koson/Senior-Project/Report Stuff/leds.jpg

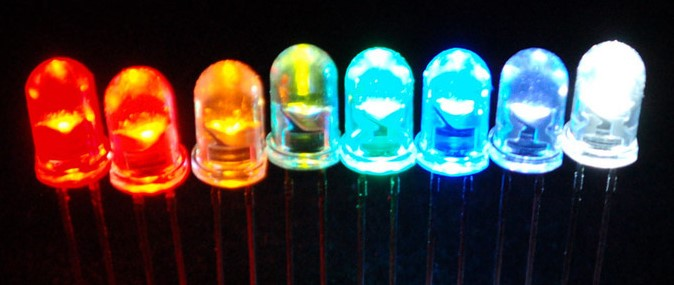
Report Stuff/leds.jpg
