koson/Senior-Project/Report Stuff/keypad.png

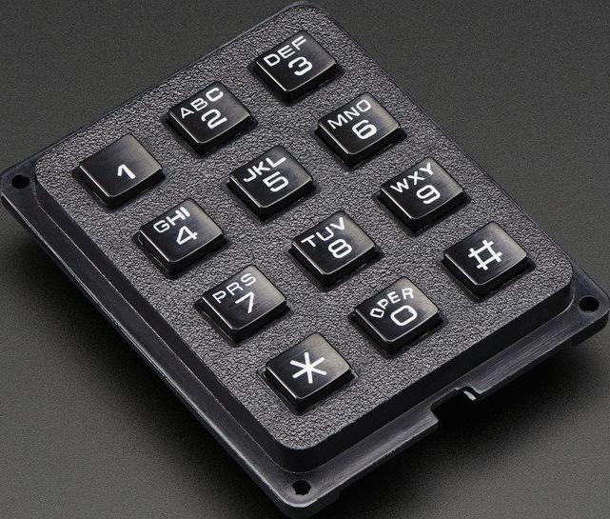
Report Stuff/keypad.png
