koson/Senior-Project/README.txt

This is the repository for the "Granny Safe" senior project
