koson/Senior-Project/Granny Safe Hardware Block Diagram.docx

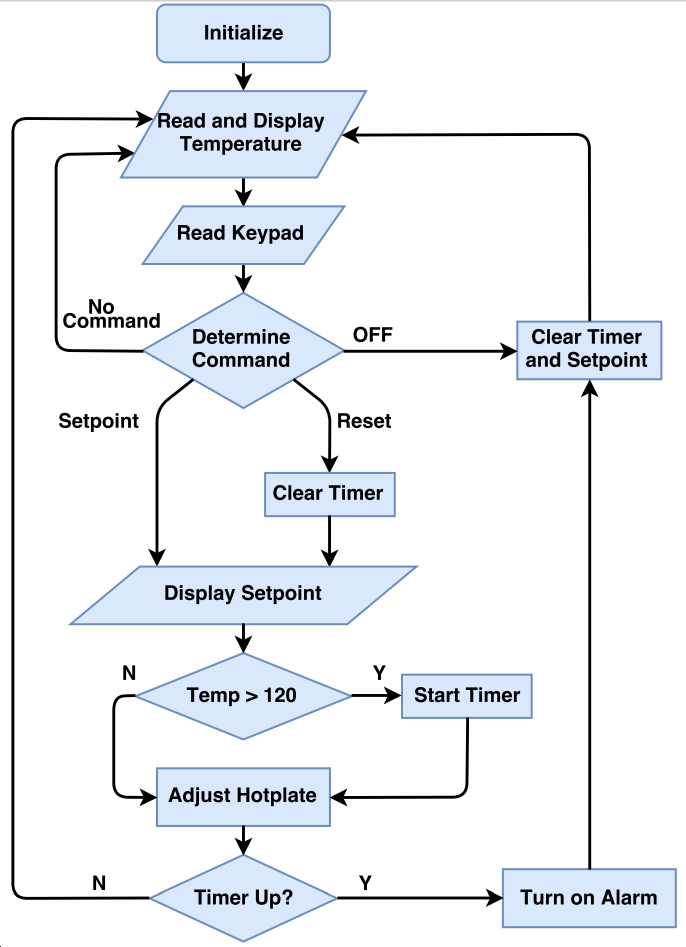
[picture p3: figure]

Granny Safe Software Flow Chart
