koson/Senior-Project/Transmittal Documents/Acknowledgement and Sources.pdf

Acknowledgements:

Nuri, Segee, Sheaf, Payne, Yifeng, Hanselman

Sources:

1. A.S. Sedra, K.C. Smith, “Microelectronic Circuits,” Oxford University Press, New York, New York, pp. 76-80, 2010.
