koson/Senior-Project/402-Design-Review-Rubric.ods

 | Expectations |  | Comments | Weight | Score |  | Expectations |  | Comments | Weight | Score
Docs | Well written and presented progress reports. Schedule, Expense report, and Hardware/software block diagram up is to date and complete. Schematics are to standards, up to date, and complete. Every document has less than two errors. |  |  | 0-10 |  | Hardware Design | Explanation of hardware design is clear, well reasoned, well supported by engineering justifications. Design is clearly communicated during design review. |  |  | 0-40
 |  |  |  |  |  |  | Additionally, the team exhibits the following characteristics to support the design:
Notebooks | Up to date, shows consistent and continuous progress, in ink, signed and dated, and well documented. |  |  | 0-10 |  |  | • | Meets Contract
 | Name : |  |  |  |  |  | • | Scope and depth of project extends well beyond senior level
 | Up to date, shows consistent and continuous progress, in ink, signed and dated, well documented. |  |  | 0-10 |  |  | • | Understanding of design is deep and complete
 | Name: |  |  |  |  |  | • | Circuits used are not copied from course work, app notes, nor data sheets
Test Equip | Test equipment measurement set up correctly and quickly. Oscilloscope usage includes proper horizontal, vertical, differential, and trigger setup. |  |  | 0-10 |  |  | • | Mixed signals and various voltage levels are properly handled correctly
 |  |  |  |  |  |  | • | Modular design is used
Sim & Vrfy | System was thoroughly simulated and/or operation empirically verified. Evidence shown in notebooks. |  |  | 0-10 |  |  | • | Design is thoroughly documented
 |  |  |  |  |  |  | • | Device choices and components are thoroughly researched and considered .
Prototyping | Explanation of prototyping method is clear, well reasoned, well supported by engineering justifications. Design is clearly communicated during design review. |  |  | 0-20 |  | Software Design | Explanation of software design is clear, well reasoned, well supported by engineering justifications. Design is clearly communicated during design review. |  |  | 0
 | Additionally, the team exhibits the following characteristics to support the design: |  |  |  |  |  | Additionally, the team exhibits the following characteristics to support the design:
 | • | PCBs are used and robustly built |  |  |  |  | • | Meets Contract
 | • | Lab power supplies are not used to power the device |  |  |  |  | • | Scope and depth of project extends well beyond senior level
 | • | The device is securely mounted |  |  |  |  | • | Understanding of design is deep and complete
 | • | Proper wire gauges, types, and colors are used |  |  |  |  | • | Array bounds are checked and error appropriately handled
 | • | Power and ground are properly distributed |  |  |  |  | • | Return values are checked and errors appropriately handled
 | • | Power and ground use a connection tree |  |  |  |  | • | Use of global variables is minimal
 | • | Bypass capacitors are properly used |  |  |  |  | • | User input does not make the system fail
 | • | Dangerous voltages cannot contact people |  |  |  |  | • | Structured languages are written to contain functions, modules, and libraries
 | • | Connectors are used and all are labeled |  |  |  |  | • | Coding style and indentation uses accepted practices
 | • | High quality work |  |  |  |  | • | Code is written to be portable
 | • |  |  |  |  |  | • | Algorithms are written to reduce computation
PSF | Scale factor for projects with innovative and in-depth design and meeting dead lines including qualifiers |  |  | % |  |  | • | Interrupts are used appropriately
 |  |  |  |  |  |  | • | Functions have clear and concise interface
 |  |  |  |  |  |  | • | Revision control system used
 |  |  |  |  |  |  | • | Comments clearly describe the algorithmic design
 |  | Name : | Grade |  | 0 |  |  | Name: | Grade |  | 0
