koson/Senior-Project/2624_001.pdf

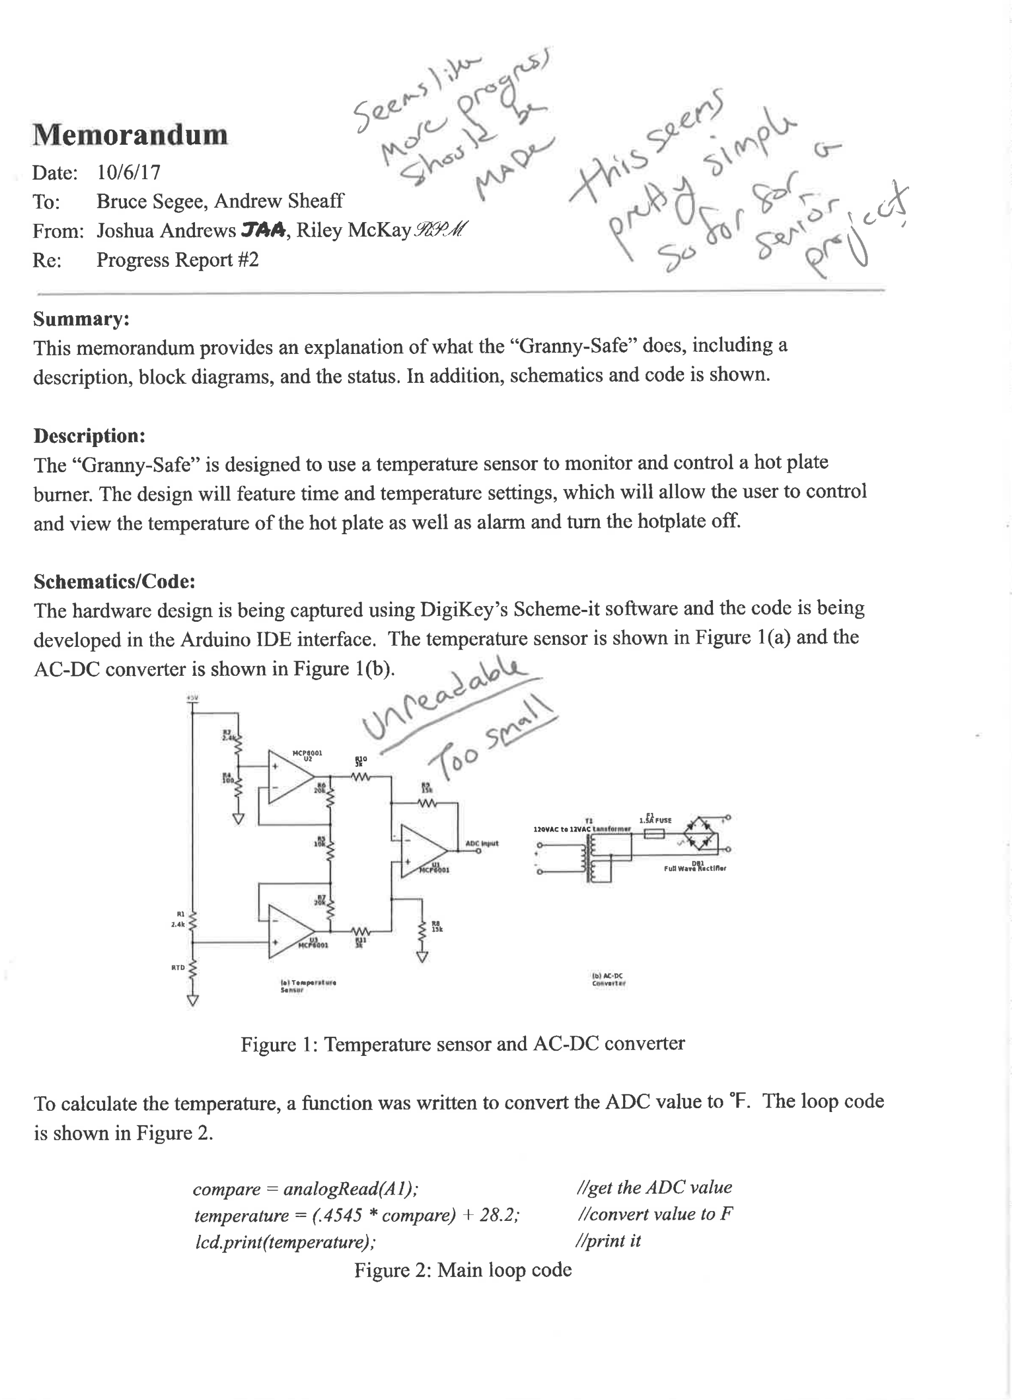
[picture p29: page 1]
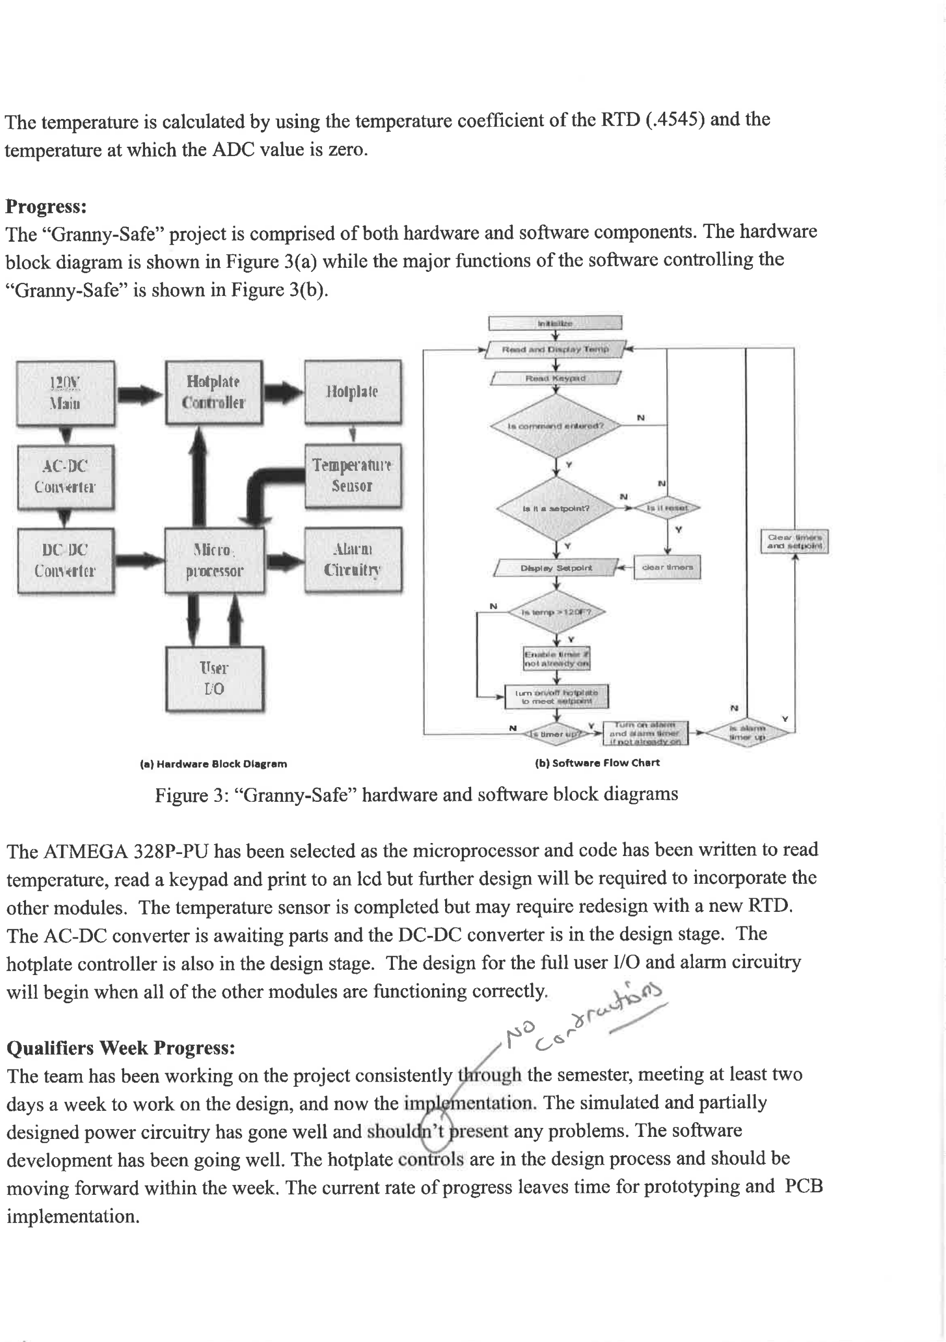
[picture p30: page 2]
