koson/Senior-Project/Transmittal Documents/Memorandum 1 ECP403.pdf

## Memorandum

Date: 1/28/18
To: Elizabeth Payne
From: Joshua Andrews JAA, Riley McKay RPM
Re: Memo assignment: Introduction, block diagram, explanation of signal flow, two outlines, a list of sources and acknowledgments, and a copy of the project contract

Here are the documents you requested on 1/22/18. They consist of the introduction, block diagram and explanation, an outline from each team partner, sources and acknowledgements, and the contract for the project.
