koson/Senior-Project/Report Stuff/CSVs/triac1.xlsx

Time(Second) | X(CH1) (Volt)
-0.029999997 | -12
-0.029899998 | -12
-0.029799998 | -12
-0.029699998 | -10
-0.029599998 | -12
-0.029499998 | -12
-0.029399998 | -12
-0.029299999 | -12
-0.029199999 | -10
-0.029099999 | -12
-0.028999999 | -10
-0.028899999 | -8
-0.0288 | -8
-0.0287 | -10
-0.0286 | -10
-0.0285 | -8
-0.0284 | -8
-0.0283 | -12
-0.028200001 | -10
-0.028100001 | -8
-0.028000001 | -8
-0.027900001 | -6
-0.027800001 | -8
-0.027700001 | -2
-0.027600002 | -6
-0.027500002 | -2
-0.027400002 | -2
-0.027300002 | -2
-0.027200002 | -2
-0.027100002 | -2
-0.027000003 | -2
-0.026900003 | -2
-0.026800003 | -2
-0.026700003 | -2
-0.026600003 | -2
-0.026500003 | 0
-0.026400004 | -2
-0.026300004 | 0
-0.026200004 | 0
-0.026100004 | -2
-0.026000004 | 2
-0.025900004 | 4
-0.025800005 | 4
-0.025700005 | 6
-0.025600005 | 6
-0.025500005 | 6
-0.025400005 | 6
-0.025300005 | 6
-0.025200006 | 6
-0.025100006 | -124
-0.025000006 | -128
-0.024900006 | -118
-0.024800006 | -118
-0.024700006 | -102
-0.024600007 | -104
-0.024500007 | -94
-0.024400007 | -92
-0.024300007 | -82
-0.024200007 | -80
-0.024100007 | -70
-0.024000008 | -66
-0.023900008 | -52
-0.023800008 | -52
-0.023700008 | -42
-0.023600008 | -40
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
