koson/Senior-Project/Report Stuff/CSVs/setacc.xlsx

stdH | stdL | setpoint
98 | 102 | 100
103 | 106.5 | 105
107.5 | 112 | 110
112.5 | 116.5 | 115
117.5 | 122 | 120
123 | 127 | 125
128 | 132.5 | 130
133 | 136.5 | 135
138 | 142 | 140
143.5 | 147 | 145
148 | 152 | 150
153 | 158 | 155
156 | 163 | 160
162.5 | 167.5 | 165
167.5 | 173 | 170
173 | 177 | 175
178 | 182 | 180
183.5 | 187.5 | 185
188 | 192 | 190
193 | 197 | 195
198 | 203 | 200
203 | 207 | 205
208 | 213 | 210
213 | 217 | 215
218 | 221.5 | 220
223 | 227.5 | 225
228 | 232 | 230
233 | 237.5 | 235
237.5 | 242 | 240
242 | 246.5 | 245
249 | 253 | 250
252 | 258.5 | 255
258.5 | 262 | 260
263 | 267 | 265
268 | 273 | 270
272 | 278.5 | 275
277 | 282 | 280
282 | 287 | 285
288 | 292 | 290
293 | 298 | 295
298 | 302 | 300
303 | 307 | 305
308 | 312 | 310
312 | 317.5 | 315
318 | 322 | 320
323 | 327 | 325
328 | 332 | 330
333 | 337 | 335
338 | 342 | 340
340 | 347 | 345
346 | 355 | 350
352 | 358 | 355
358 | 362 | 360
362 | 367 | 365
367 | 374 | 370
373 | 377 | 375
377.5 | 382 | 380
382 | 388 | 385
385 | 393 | 390
392 | 397 | 395
396 | 405 | 400
