koson/Senior-Project/Report Stuff/CSVs/tempaccuracy.xlsx

act | meas | err
100 | 99.3 | 0.7
105 | 104.4 | 0.6
110 | 109.4 | 0.6
115 | 114.5 | 0.5
120 | 119.5 | 0.5
125 | 124.5 | 0.5
130 | 129.6 | 0.4
135 | 134.6 | 0.4
140 | 139.6 | 0.4
145 | 144.6 | 0.4
150 | 149.7 | 0.3
155 | 154.7 | 0.3
160 | 159.7 | 0.3
165 | 164.8 | 0.2
170 | 169.8 | 0.2
175 | 174.8 | 0.2
180 | 179.8 | 0.2
185 | 184.8 | 0.2
190 | 189.8 | 0.2
195 | 194.9 | 0.1
200 | 199.9 | 0.1
205 | 205 | 0
210 | 210 | 0
215 | 215.1 | 0.1
220 | 220.1 | 0.1
225 | 225.1 | 0.1
230 | 230.1 | 0.1
235 | 235.2 | 0.2
240 | 240.2 | 0.2
245 | 245.3 | 0.3
250 | 250.3 | 0.3
255 | 255.3 | 0.3
260 | 260.4 | 0.4
265 | 265.4 | 0.4
270 | 270.5 | 0.5
275 | 275.5 | 0.5
280 | 280.5 | 0.5
285 | 285.6 | 0.6
290 | 290.6 | 0.6
295 | 295.6 | 0.6
300 | 300.7 | 0.7
305 | 305.7 | 0.7
310 | 310.6 | 0.6
315 | 315.7 | 0.7
320 | 320.7 | 0.7
325 | 325.8 | 0.8
330 | 330.8 | 0.8
335 | 335.8 | 0.8
340 | 340.8 | 0.8
345 | 345.8 | 0.8
350 | 350.9 | 0.9
355 | 355.9 | 0.9
360 | 360.9 | 0.9
365 | 365.9 | 0.9
370 | 371 | 1
375 | 376 | 1
380 | 381 | 1
385 | 386 | 1
390 | 391.1 | 1.1
395 | 396.1 | 1.1
400 | 401.2 | 1.2
