koson/Senior-Project/Atmega/Atmega328 pinout.png

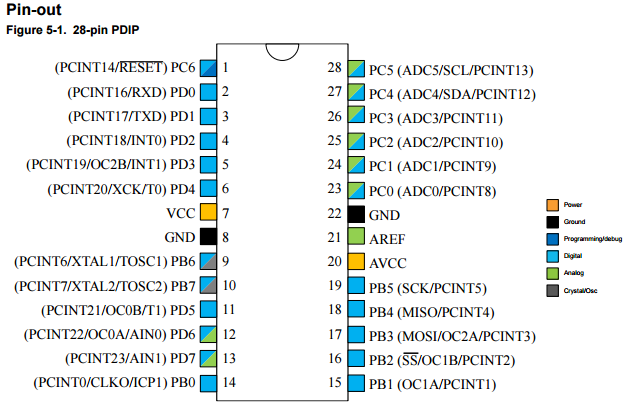
Atmega/Atmega328 pinout.png
