koson/Senior-Project/Gifs-Presentation/grandmother.png

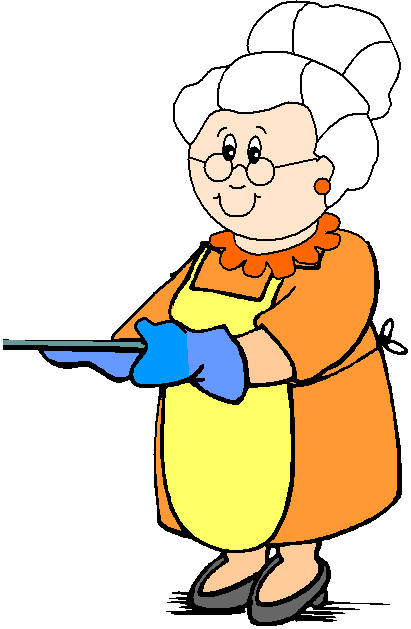
Gifs-Presentation/grandmother.png
