koson/Senior-Project/Gifs-Presentation/tenor (1).gif

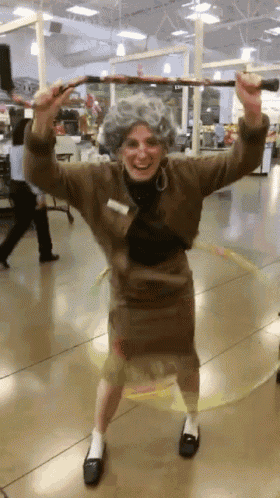
Gifs-Presentation/tenor (1).gif
