koson/Senior-Project/Gifs-Presentation/tenor (2).gif

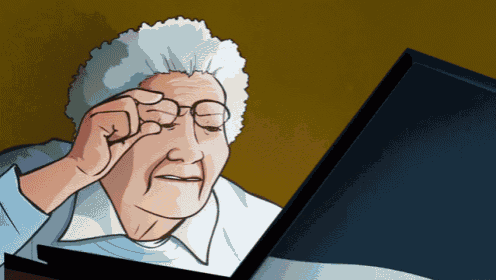
Gifs-Presentation/tenor (2).gif
