koson/Senior-Project/Gifs-Presentation/tenor (3).gif

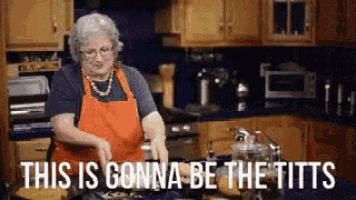
Gifs-Presentation/tenor (3).gif
