koson/Senior-Project/Gifs-Presentation/tenor (4).gif

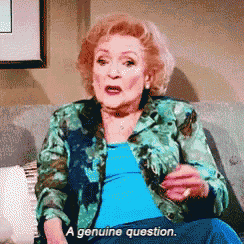
Gifs-Presentation/tenor (4).gif
