koson/Senior-Project/Gifs-Presentation/tenor (5).gif

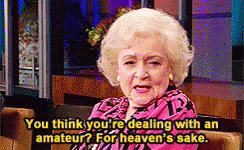
Gifs-Presentation/tenor (5).gif
