koson/Senior-Project/Gifs-Presentation/tenor.gif

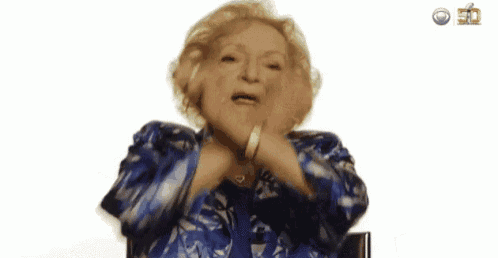
Gifs-Presentation/tenor.gif
