koson/Senior-Project/Pictures/20170405_121246.jpg

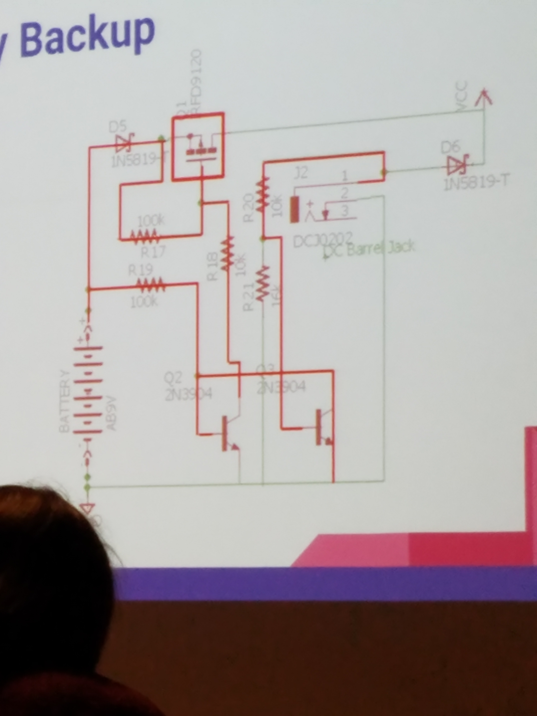
Pictures/20170405_121246.jpg
