koson/Senior-Project/Pictures/20170405_121846.jpg

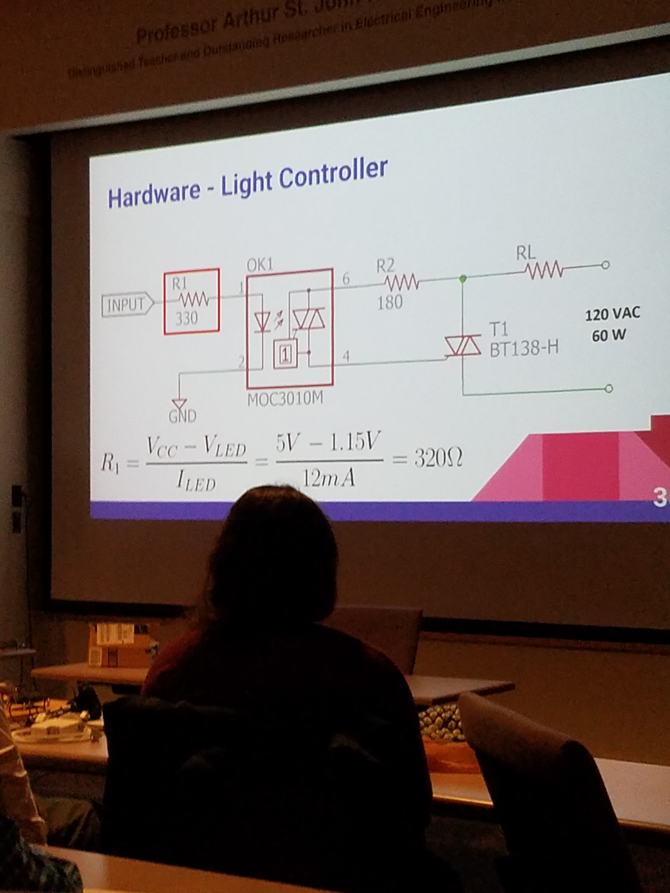
Pictures/20170405_121846.jpg
