koson/Senior-Project/Pictures/20170405_121858.jpg

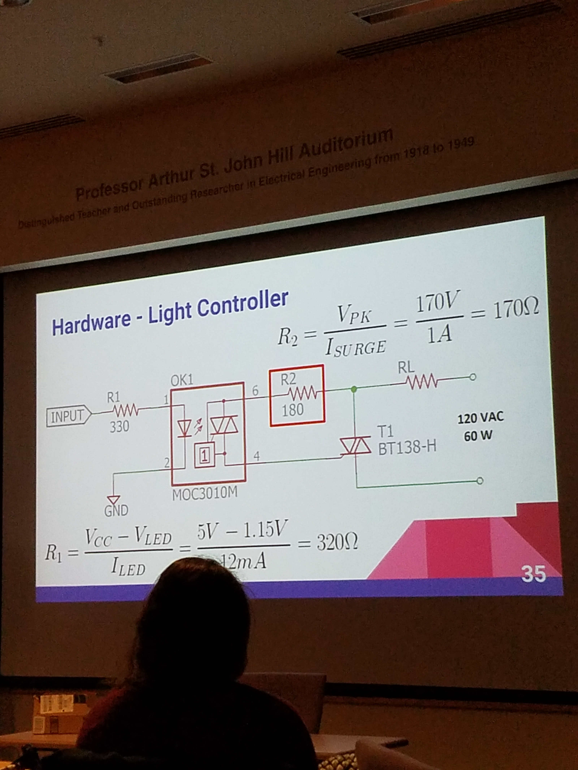
Pictures/20170405_121858.jpg
