koson/Senior-Project/Pictures/IOpin.png

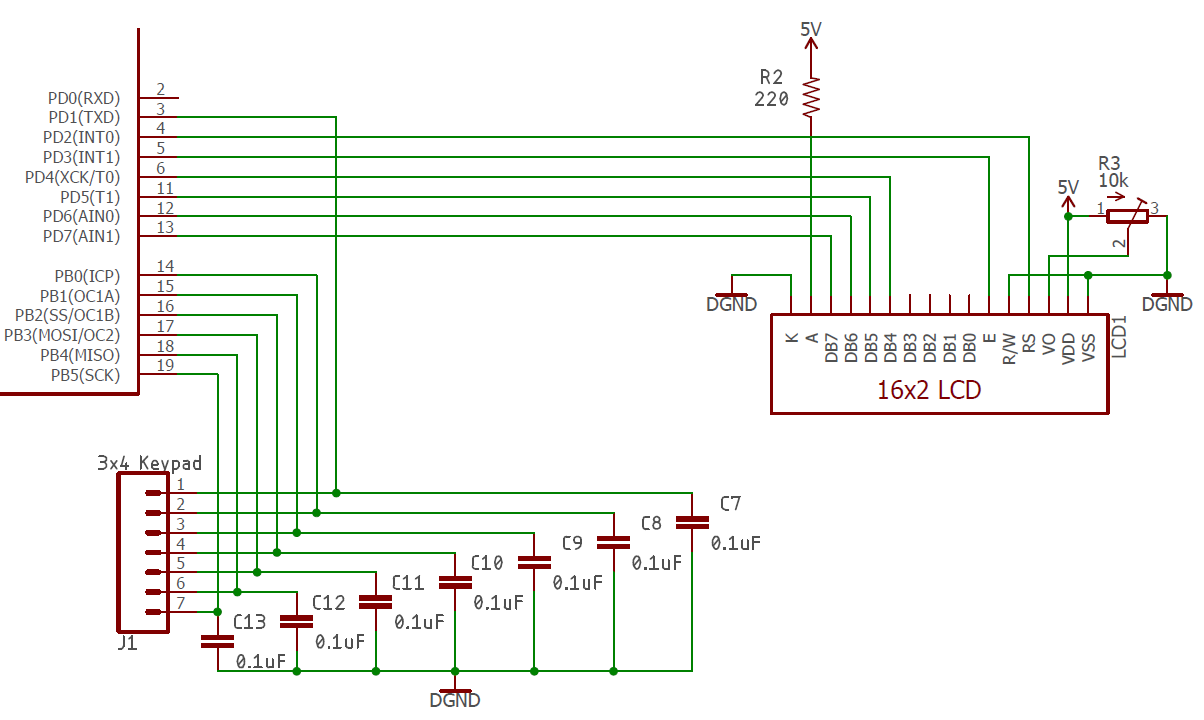
Pictures/IOpin.png
