koson/Senior-Project/Pictures/Microprocessor Circuitry.png

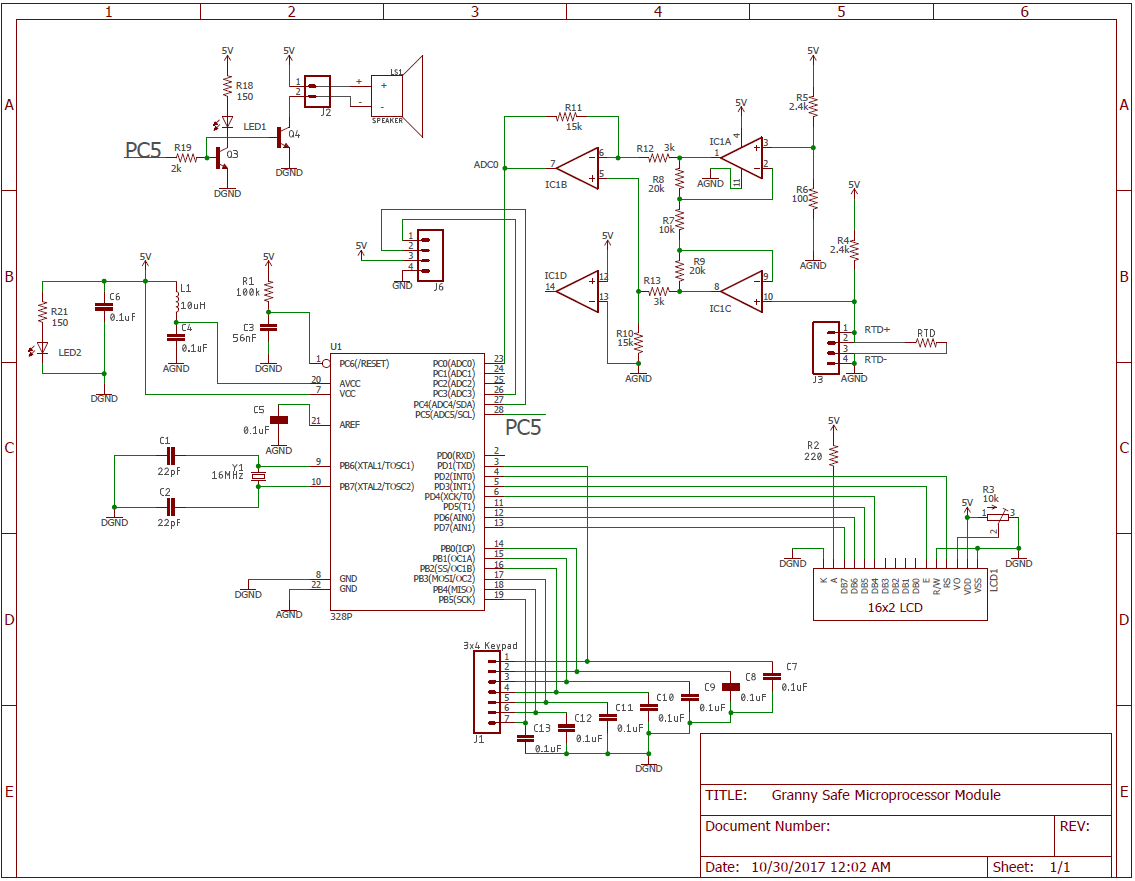
Pictures/Microprocessor Circuitry.png
