koson/Senior-Project/Pictures/Power Supply.png

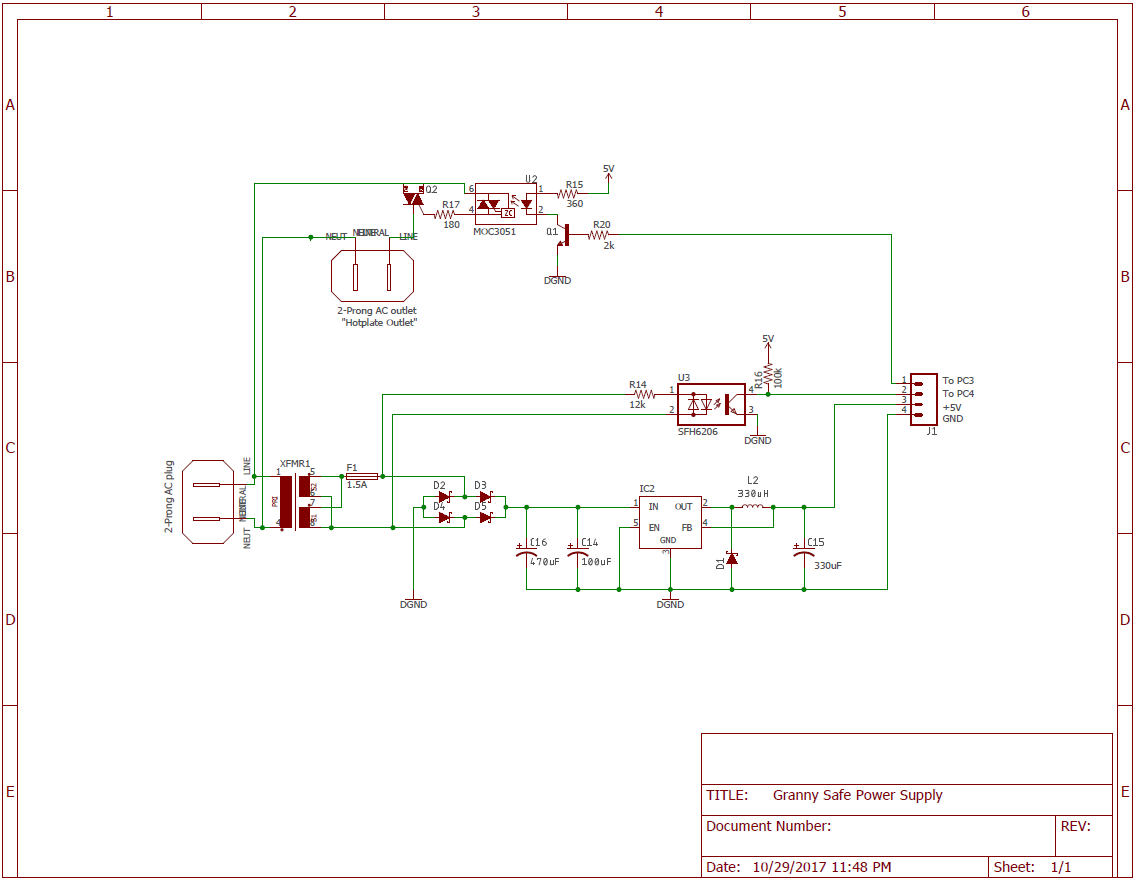
Pictures/Power Supply.png
