koson/Senior-Project/Pictures/Tempsens.png

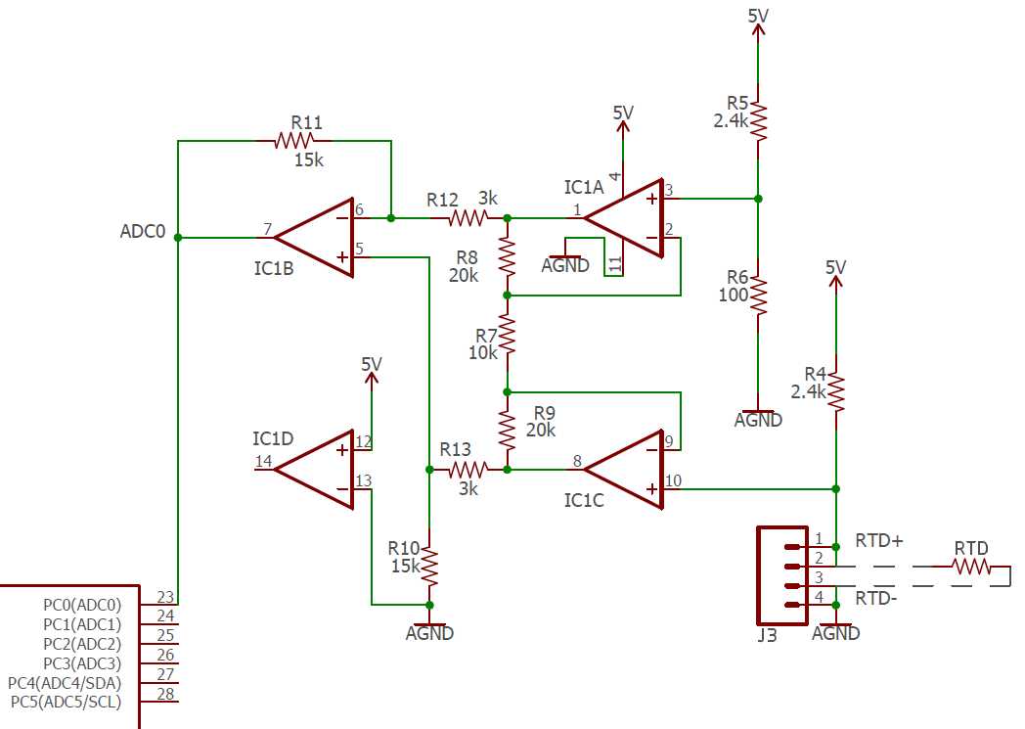
Pictures/Tempsens.png
