koson/Senior-Project/Pictures/Triac.png

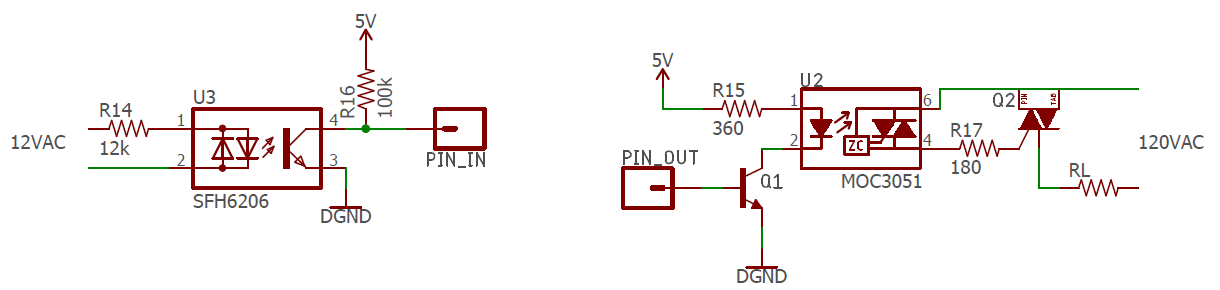
Pictures/Triac.png
