koson/Senior-Project/Report Stuff/alarmled (adafruit).png

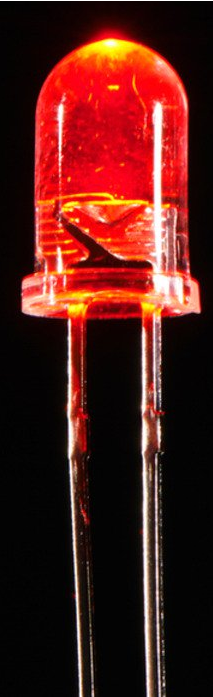
Report Stuff/alarmled (adafruit).png
