koson/Senior-Project/Report Stuff/alarmsch.png

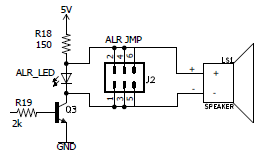
Report Stuff/alarmsch.png
