koson/Senior-Project/Report Stuff/anova.jpg

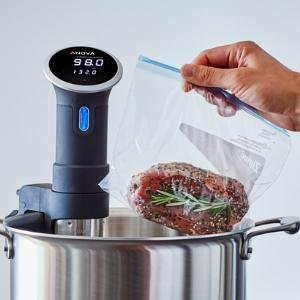
Report Stuff/anova.jpg
