koson/Senior-Project/Report Stuff/arduino uno.png

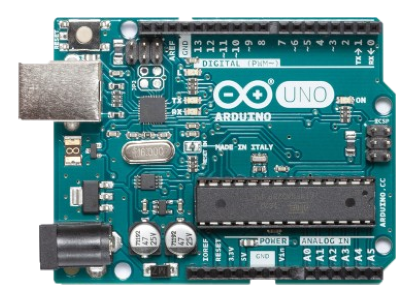
Report Stuff/arduino uno.png
