koson/Senior-Project/Report Stuff/Atmega chip.jpg

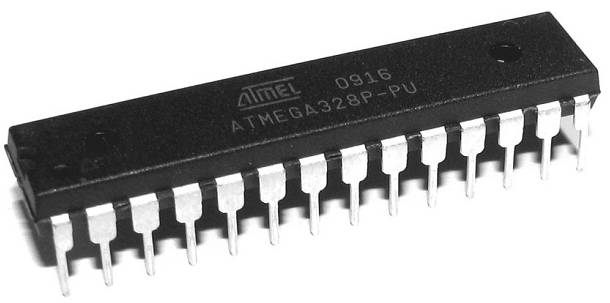
Report Stuff/Atmega chip.jpg
