koson/Senior-Project/Report Stuff/Block Diagram 3.0 (1).png

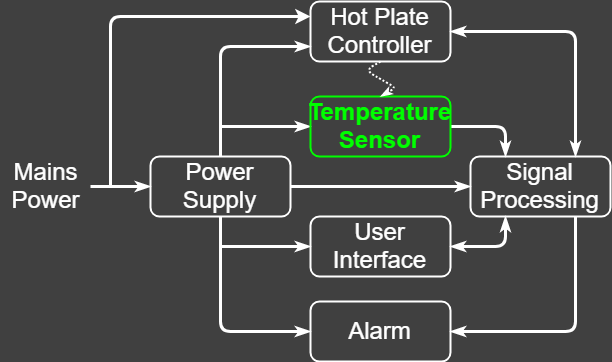
Report Stuff/Block Diagram 3.0 (1).png
