koson/Senior-Project/Report Stuff/Buck-Converter.png

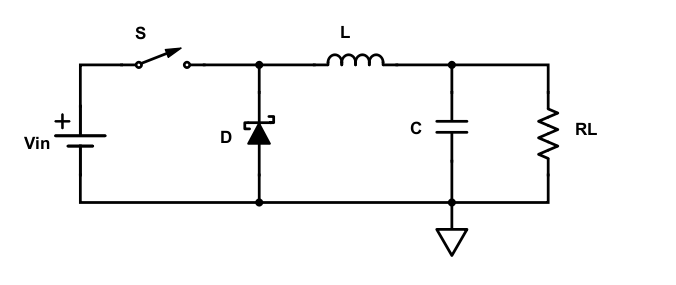
Report Stuff/Buck-Converter.png
