koson/Senior-Project/Report Stuff/currentspec.jpg

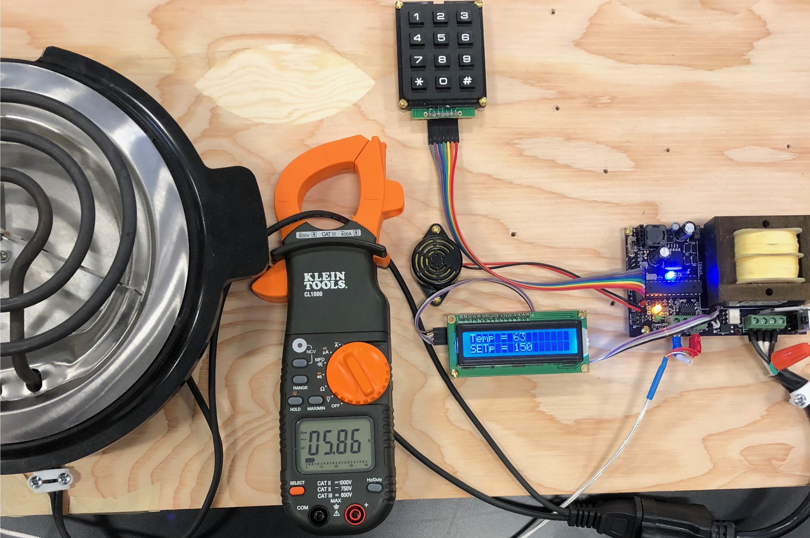
Report Stuff/currentspec.jpg
