koson/Senior-Project/Report Stuff/equiv triac.png

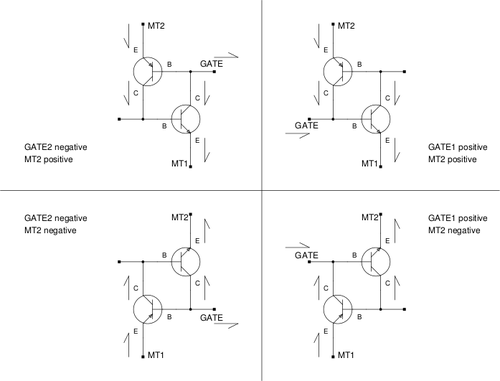
Report Stuff/equiv triac.png
