koson/Senior-Project/Report Stuff/fire advert.png

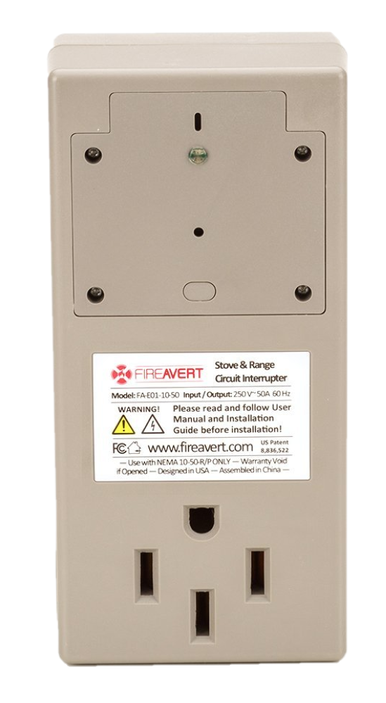
Report Stuff/fire advert.png
