koson/Senior-Project/Report Stuff/iguard.png

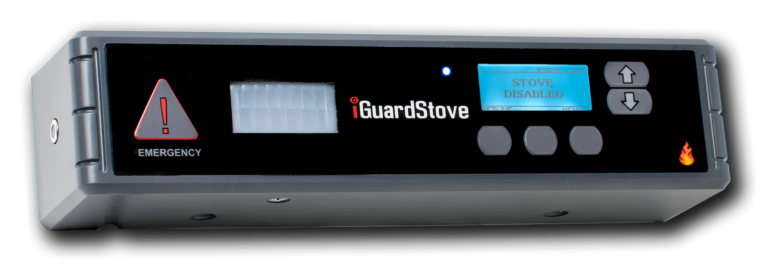
Report Stuff/iguard.png
