koson/Senior-Project/Report Stuff/IMG-0240.JPG

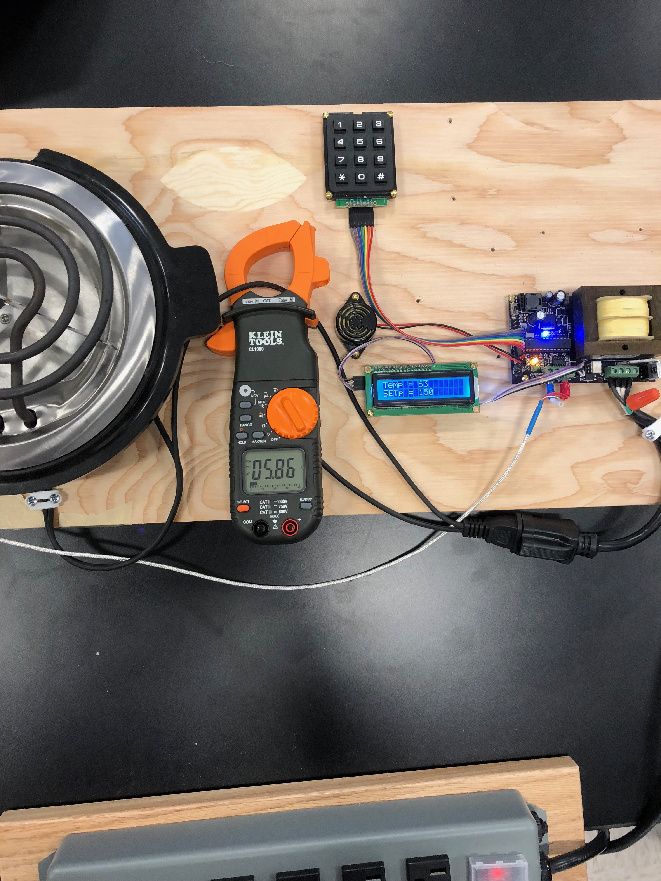
Report Stuff/IMG-0240.JPG
