koson/Senior-Project/Report Stuff/kitchenfire.jpg

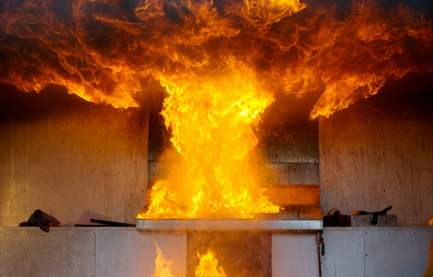
Report Stuff/kitchenfire.jpg
