koson/Senior-Project/Report Stuff/lcd.jpg

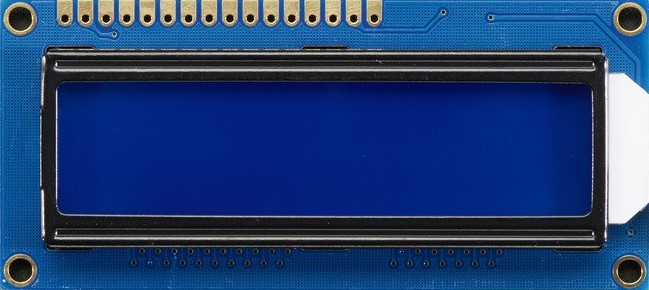
Report Stuff/lcd.jpg
