koson/Senior-Project/Report Stuff/piezo.jpg

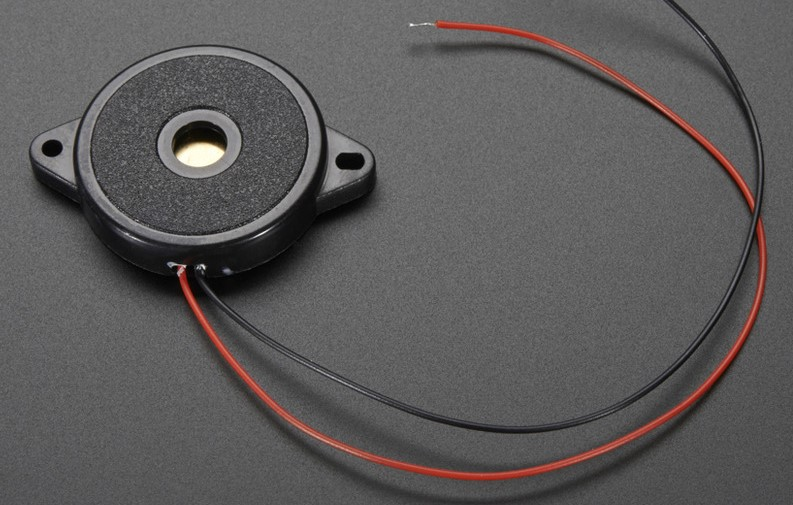
Report Stuff/piezo.jpg
