koson/Senior-Project/Report Stuff/pwrsup_sch.png

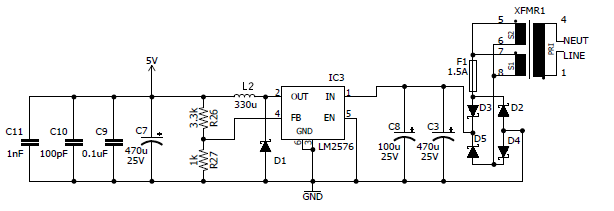
Report Stuff/pwrsup_sch.png
