koson/Senior-Project/Report Stuff/rectifier.png

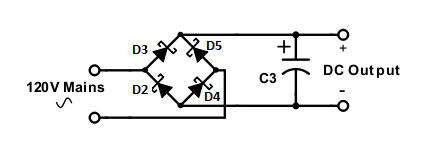
Report Stuff/rectifier.png
