koson/Senior-Project/Report Stuff/rtd.jpg

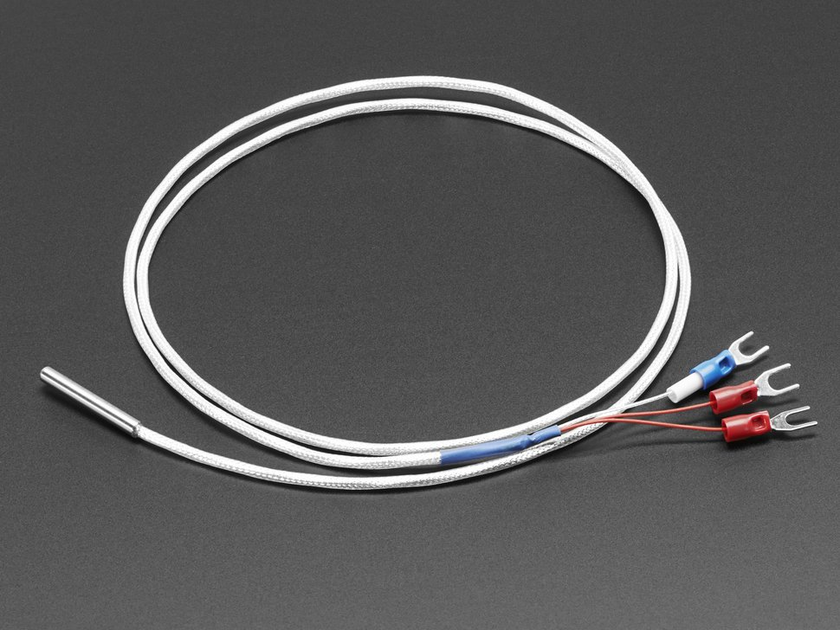
Report Stuff/rtd.jpg
