koson/Senior-Project/Report Stuff/safety.png

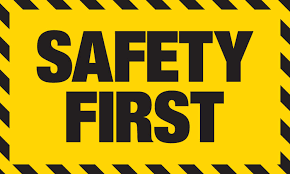
Report Stuff/safety.png
