koson/Senior-Project/Report Stuff/schematic for presentation.png

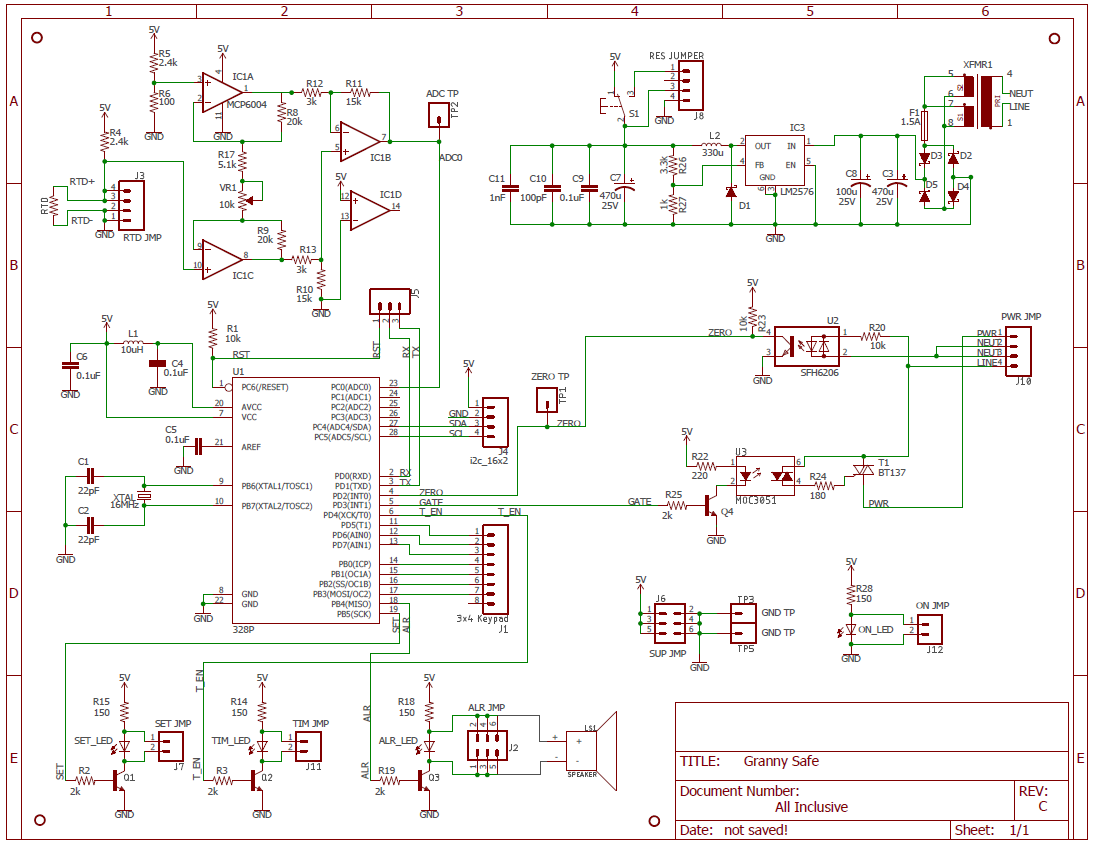
Report Stuff/schematic for presentation.png
