koson/Senior-Project/Report Stuff/Tempsensor.png

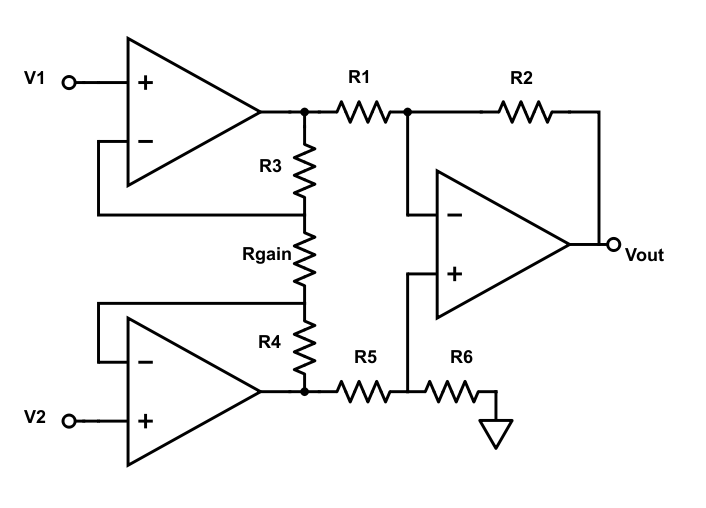
Report Stuff/Tempsensor.png
