koson/Senior-Project/Report Stuff/timing_as.gif

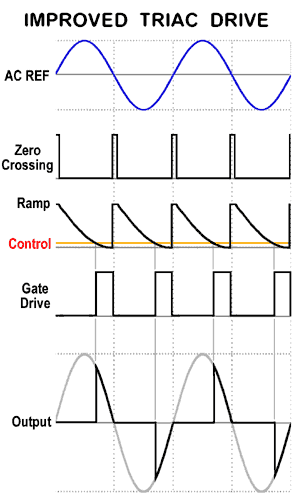
Report Stuff/timing_as.gif
