koson/Senior-Project/Report Stuff/triac ac wave.jpg

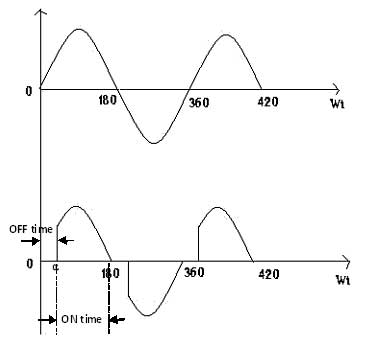
Report Stuff/triac ac wave.jpg
