koson/Senior-Project/Report Stuff/triac contruction.gif

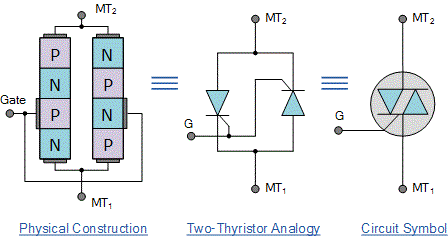
Report Stuff/triac contruction.gif
