koson/Senior-Project/Report Stuff/triac_control_sch.png

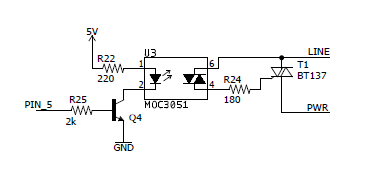
Report Stuff/triac_control_sch.png
