koson/Senior-Project/Report Stuff/Zero+triac.png

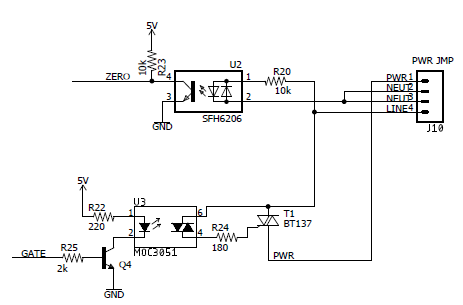
Report Stuff/Zero+triac.png
