koson/Senior-Project/Report Stuff/zsense_sch.png

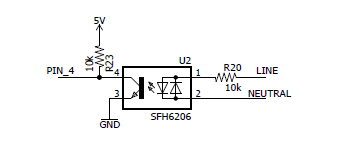
Report Stuff/zsense_sch.png
