koson/Senior-Project/Pictures/328setup.png

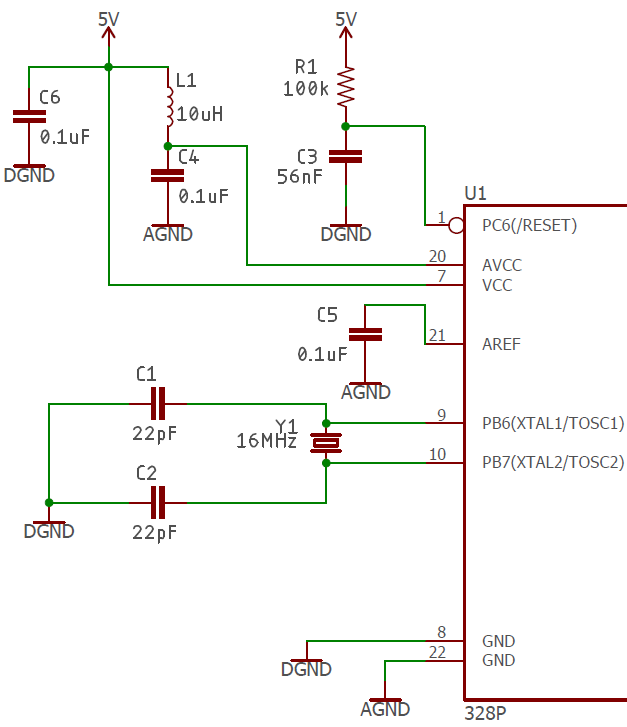
Pictures/328setup.png
