koson/Senior-Project/Black Schematic.pdf

# 6 R²⁶ R²⁷

A

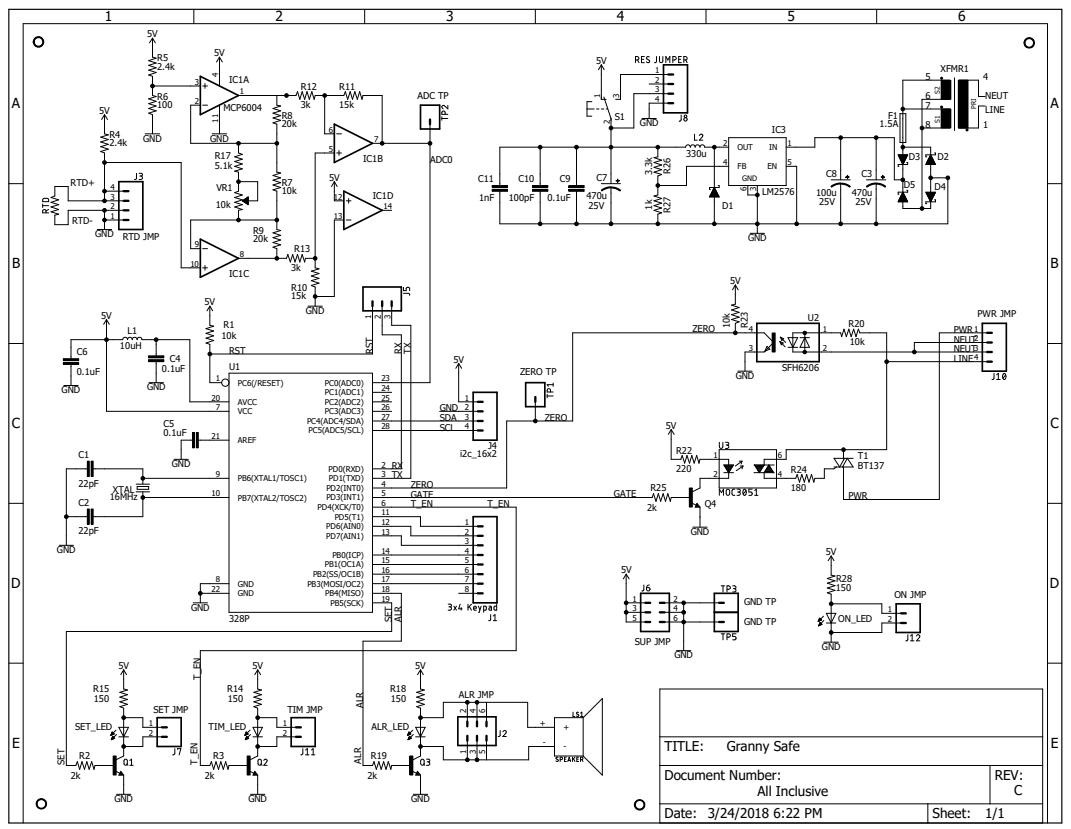
[picture p79: page 1]

Document Number: All Inclusive | REV: C

Date: 3/24/2018 6:22 PM | Sheet: 1/1
