koson/Senior-Project/Cut up schematic for report.pdf

# 6 R²⁶ R²⁷

# ADC0 T_EN

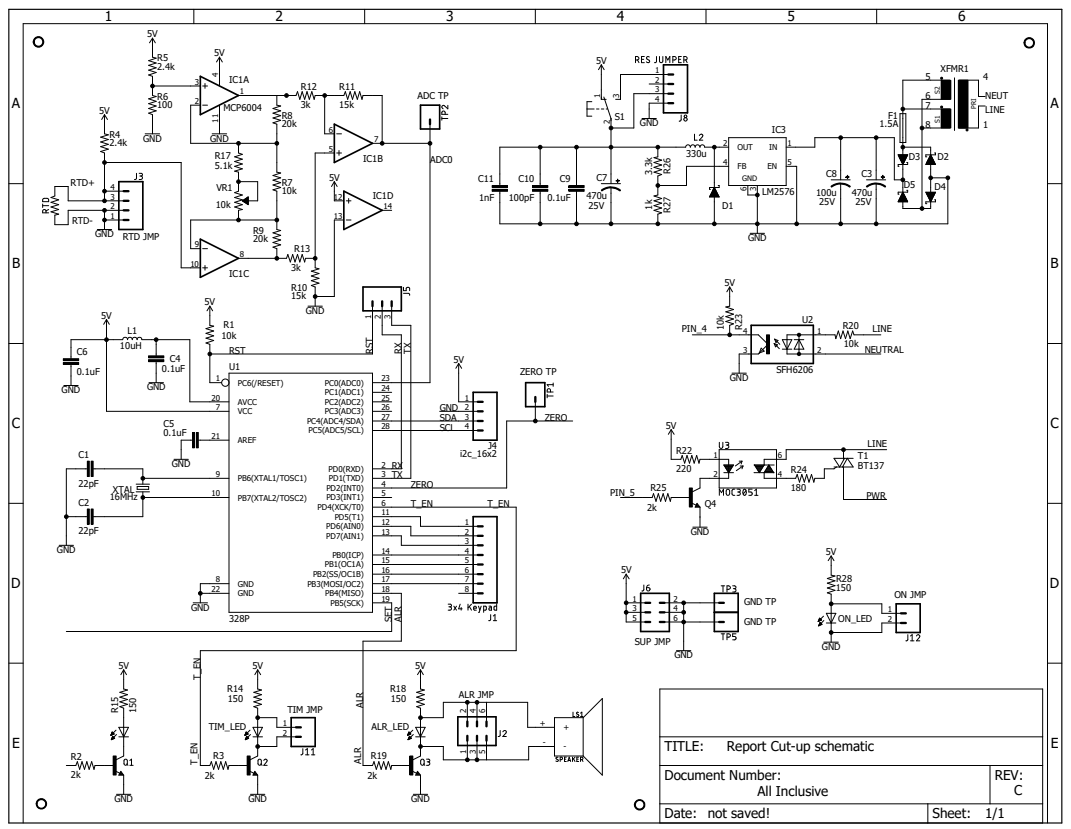
[picture p80: page 1]

Document Number: All Inclusive | REV: C

Date: not saved! | Sheet: 1/1
