koson/Senior-Project/Granny Safe Schematic 12-13-17.pdf

# 6 R²⁶ R²⁷

A

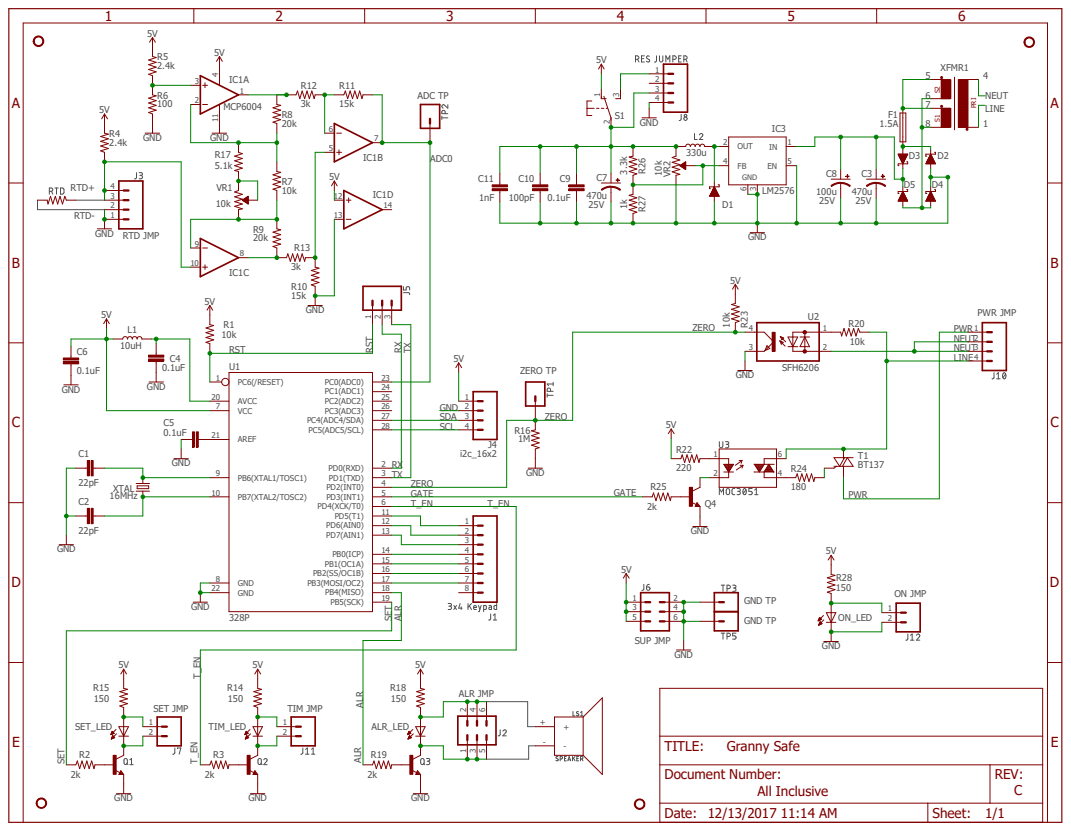
[picture p81: page 1]

Document Number: All Inclusive | REV: C

Date: 12/13/2017 11:14 AM | Sheet: 1/1
