koson/Senior-Project/Report Stuff/Granny Safe Schematic 3-24-17.pdf

# 6 R²⁶ R²⁷

A

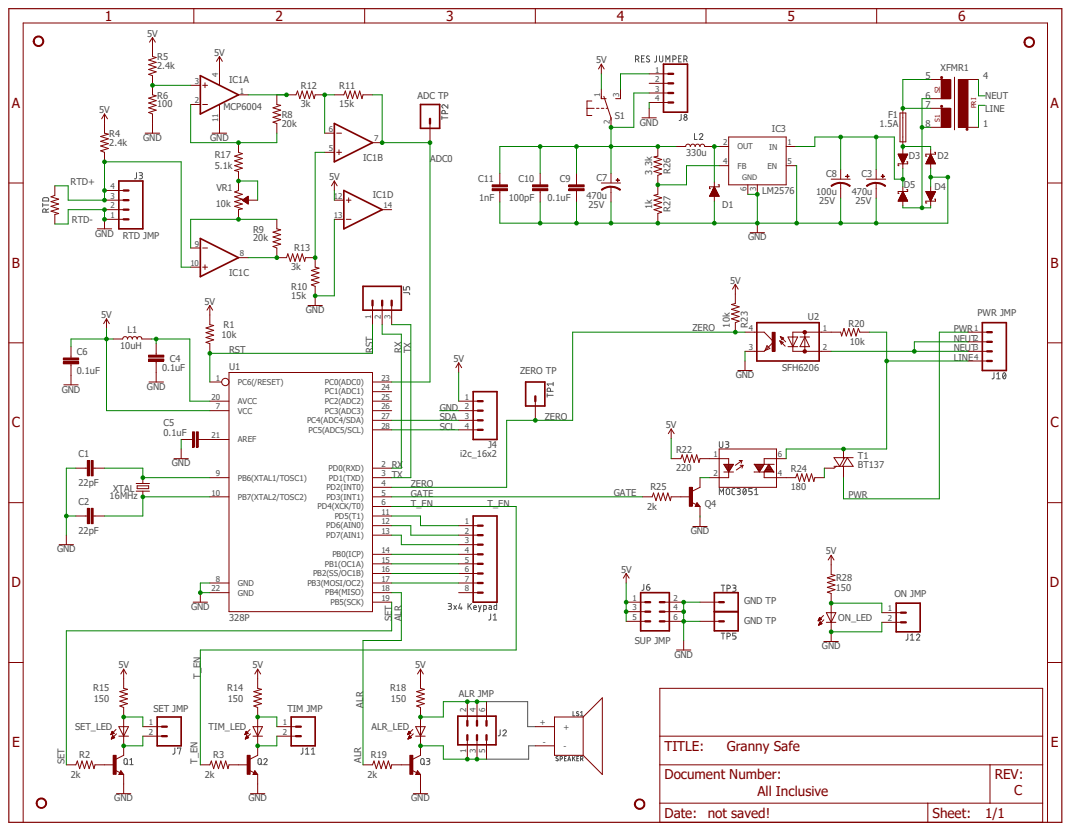
[picture p82: page 1]

Document Number: All Inclusive | REV: C

Date: not saved! | Sheet: 1/1
