koson/Senior-Project/Granny-Safe all in one.pdf

A

A

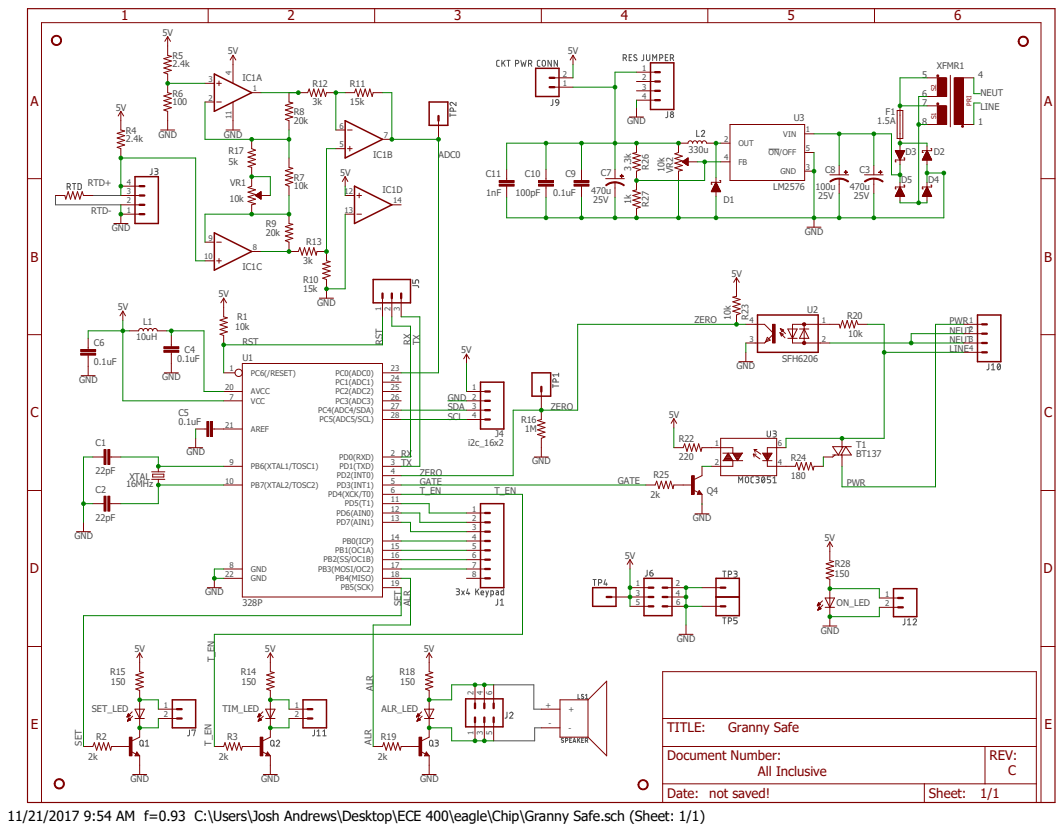
[picture p83: page 1]

Document Number: All Inclusive | REV: C

Date: not saved! | Sheet: 1/1

11/21/2017 9:54 AM f=0.93 C:\Users\Josh Andrews\Desktop\ECE 400\eagle\Chip\Granny Safe.sch (Sheet: 1/1)
