koson/Senior-Project/eagle/Temp Sensor/Temp Sensor.brd

## EAGLE design eagle/Temp Sensor/Temp Sensor.brd (2018-05-23)

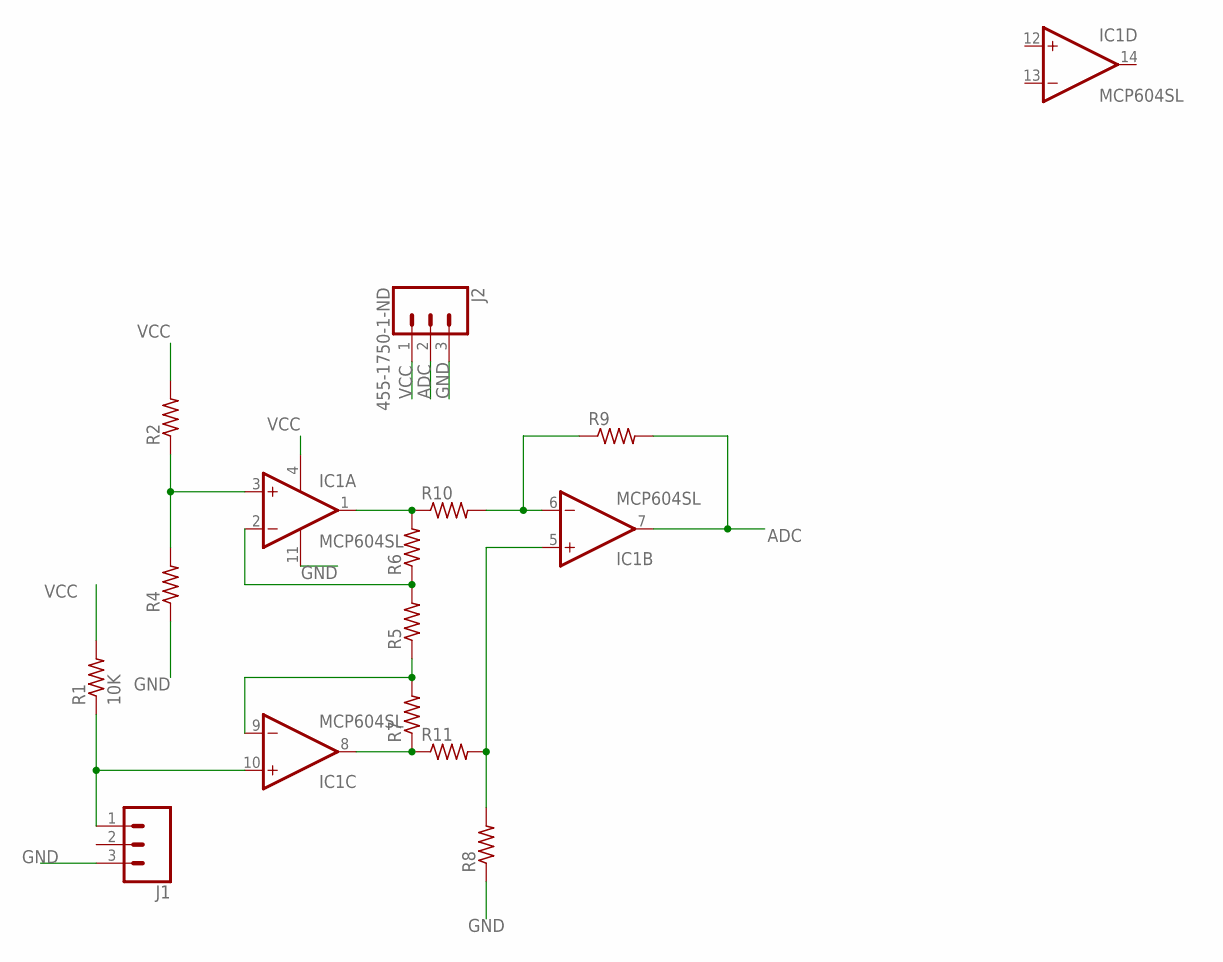
[picture p85: schematic Temp Sensor.sch]

Parts:
IC1: MCP604SL; SO14
J1: CONN_03SCREW_LOCK; SCREWTERMINAL-3.5MM-3_LOCK.007S
J2: 455-1750-1-ND; 1X03
R1: 10K; R0603
R2, R4, R5, R6, R7, R8, R9, R10, R11: R-US_R0603; R0603

Connections:
ADC: IC1.7 (OUT), J2.2, R9.2
GND: IC1.11 (V-), J1.3, J2.3, R4.1, R8.1
unnamed: IC1.10 (+IN), J1.1, R1.1
unnamed: IC1.3 (+IN), R2.1, R4.2
unnamed: IC1.8 (OUT), R7.1, R11.1
unnamed: IC1.1 (OUT), R6.2, R10.1
unnamed: IC1.2 (-IN), R5.2, R6.1
unnamed: IC1.9 (-IN), R5.1, R7.2
unnamed: IC1.5 (+IN), R8.2, R11.2
unnamed: IC1.6 (-IN), R9.1, R10.2
VCC: IC1.4 (V+), J2.1, R1.2, R2.2

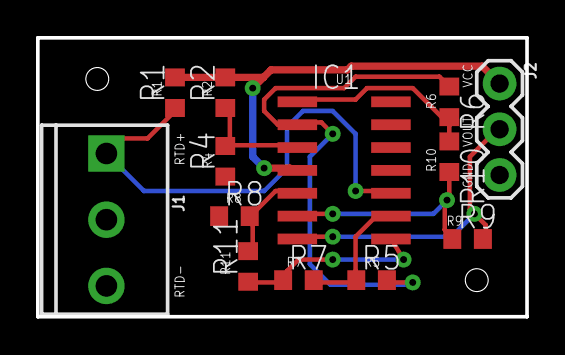
[picture p86: board Temp Sensor.brd from above]

Board: 2 copper layers, 27.2 x 15.5 mm, 13 parts (0 on the bottom side), 11 nets.
