koson/Senior-Project/eagle/Triac/Triac.brd

## EAGLE design eagle/Triac/Triac.brd (2018-05-23)

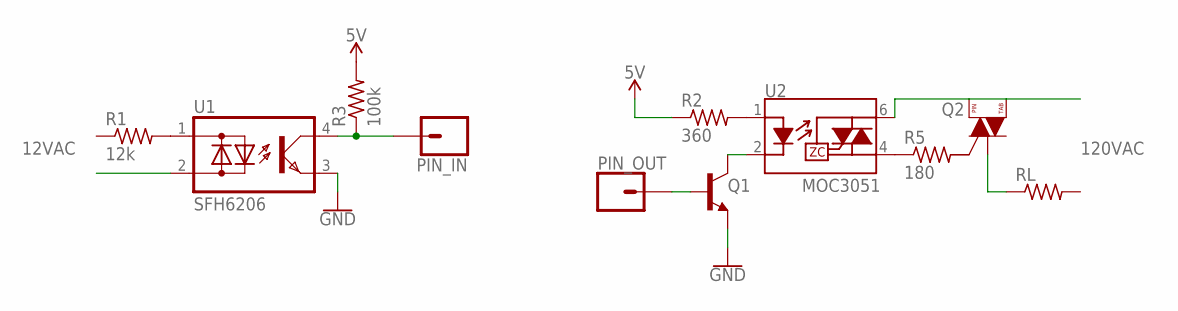
[picture p87: schematic Triac.sch]

Parts:
PIN_IN: CONN_01; 1X01
PIN_OUT: CONN_01; 1X01
Q1: TRANS_NPN-MMBTA42; SOT23-3
Q2: BT137-600E; SOT223
R1: 12k; R0603
R2: 360; R0603
R3: 100k; R0603
R5: 180; R0603
RL: R-US_R0603; R0603
U1: SFH6206; DIL4-SMD
U2: TRIAC_OPTOCOUPLER-MOC3063SM; DIP8SMD

Connections:
5V: R2.1, R3.2
GND: Q1.2 (E), U1.3 (E)
unnamed: R1.2, U1.1 (AC1)
unnamed: PIN_IN.1, R3.1, U1.4 (C)
unnamed: R2.2, U2.1 (A)
unnamed: R5.1, U2.4 (T2)
unnamed: Q2.2 (T2), Q2.4 (T2), U2.6 (T1)
unnamed: Q1.3 (C), U2.2 (K)
unnamed: PIN_OUT.1, Q1.1 (B)
unnamed: Q2.1 (T1), RL.1

Notes on the sheet:
MOC3051
12VAC
120VAC

Board: 2 copper layers, 11 parts (0 on the bottom side), 10 nets, no tracks yet.
