koson/Senior-Project/eagle/Chip/Granny Safe.brd

## EAGLE design eagle/Chip/Granny Safe.brd (2018-05-23)

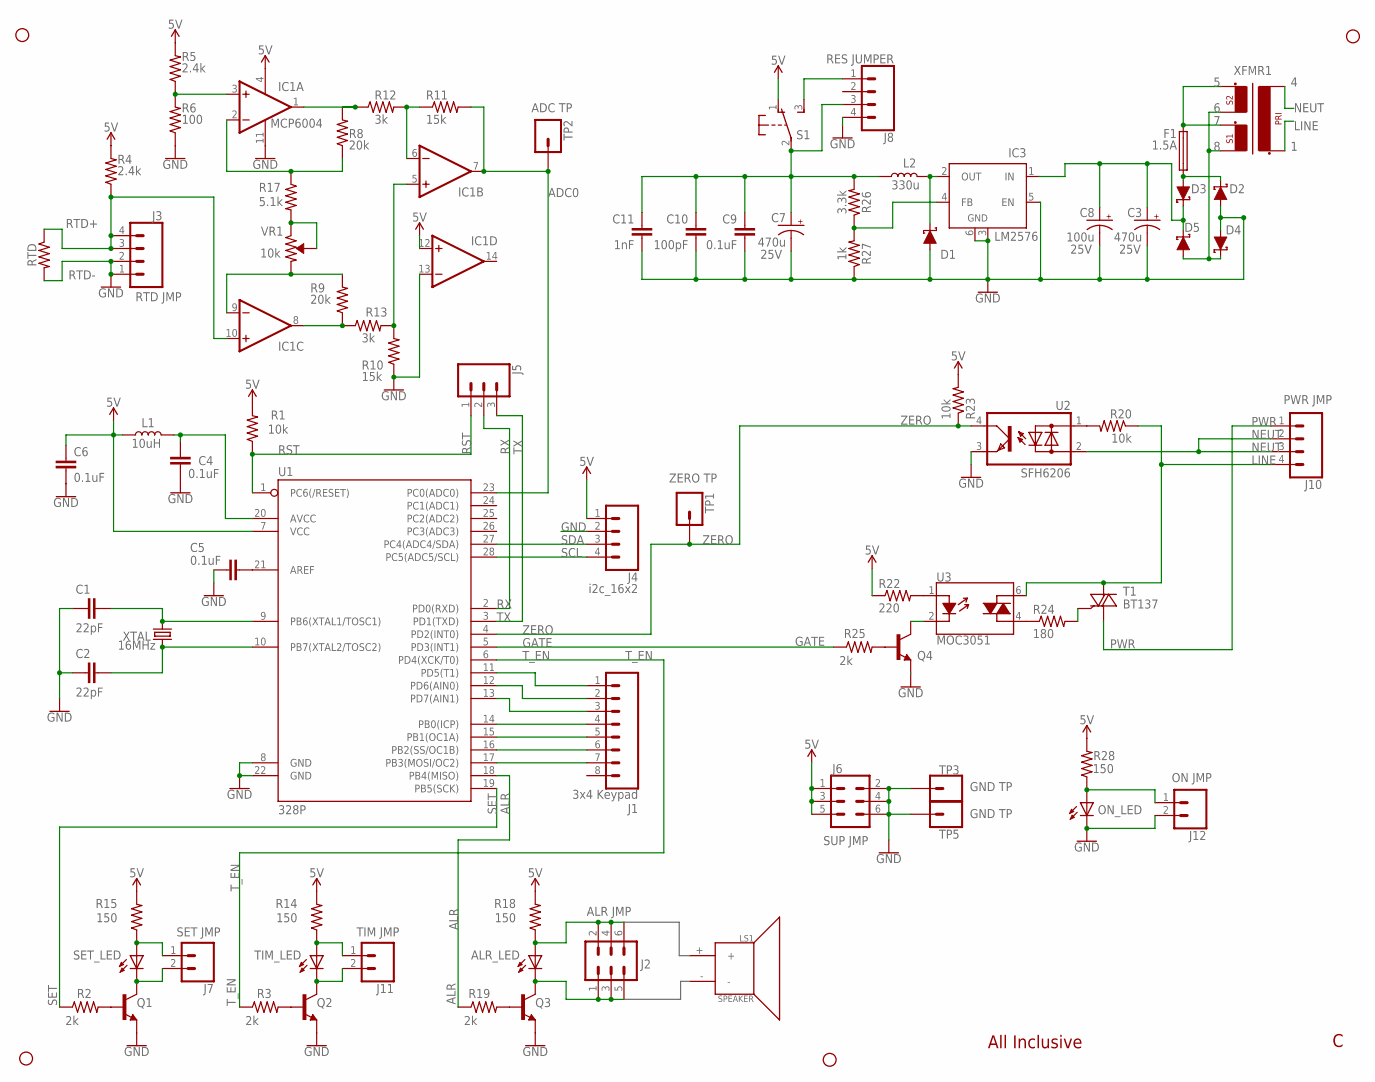
[picture p88: schematic Granny Safe.sch]

Parts:
ALR_LED: LED5MM
C1, C2: 22pF; 0603
C3, C7: 470u; E3,5-8
C4, C5, C6, C9: 0.1uF; 0603
C8: 100u; E2-5
C10: 100pF; 0603
C11: 1nF; 0603
D1, D2, D3, D4, D5: DIODE-SCHOTTKY-B340A; SMA-DIODE
F1: 1.5A; TE5
H1, H2, H3, H4: STAND-OFF
IC1: MCP604SL; SO14
IC3: LM2596S; TO263-5
J1: 3x4 Keypad; 1X08
J2, J6: FEMALE 2x3; 2X3
J3, J10: SCREW-4; SCREWTERMINAL-5MM-2
J4: i2c_16x2; 1X04
J5: CONN_03; 1X03
J7, J11, J12: CONN_02; 1X02
J8: RES JUMPER; 1X04
L1: 10uH; 0603
L2: INDUCTOR; CR75
LS1: SPEAKER; PCB_MOUNT_SPEAKER
ON_LED: LED5MM
Q1, Q2, Q3: TRANS_NPN-MMBTA42; SOT23-3
Q4: 2N3904; SOT23-3
R1: 10k; 0603
R2, R3, R19, R25: 2k; R0603
R4, R5: 2.4k; R0603
R6: 100; R0603
R8, R9: 20k; R0603
R10, R11: 15k; R0603
R12, R13: 3k; R0603
R14, R15, R18, R28: 150; R0603
R17: 5.1k; R0603
R20, R23: 10k; R0603
R22: 220; R0603
R24: 180; R0603
R26: 3.3k; 0603
R27: 1k; 0603
RTD: 10KOHM-HORIZ-1/4W-1%; AXIAL-0.3
S1: EG1213
SET_LED: LED5MM
T1: BT137; TO220BV
TIM_LED: LED5MM
TP1, TP2, TP3, TP5: CONN_01; 1X01
U1: 328P; DIP28
U2: SFH6206; DIL4-SMD
U3: MOC3051; DIP8SMD
VR1: 10k; TRIMPOT-SMD-3MM-CLOSED
XFMR1: EE20-2
XTAL: 16MHz; HC49US

Connections:
5V: C6.1, IC1.4 (V+), IC1.12 (+IN), J4.1, J6.1, J6.3, J6.5, L1.1, R1.2, R4.2, R5.2, R14.2, R15.2, R18.2, R22.1, R23.2, R28.2, S1.1 (O), U1.7 (VCC)
ADC0: IC1.7 (OUT), R11.2, TP2.1, U1.23 (PC0(ADC0))
ALR: R19.1, U1.18 (PB4(MISO))
GATE: R25.1, U1.5 (PD3(INT1))
LINE: J10.4, R20.1, T1.T2 (A2), U3.6, XFMR1.1
unnamed: C1.2, U1.9 (PB6(XTAL1/TOSC1)), XTAL.2
unnamed: C2.2, U1.10 (PB7(XTAL2/TOSC2)), XTAL.1
unnamed: J1.7, U1.17 (PB3(MOSI/OC2))
unnamed: J8.1, S1.3 (S)
unnamed: C5.1, U1.21 (AREF)
unnamed: J1.6, U1.16 (PB2(SS/OC1B))
unnamed: J1.5, U1.15 (PB1(OC1A))
unnamed: J1.4, U1.14 (PB0(ICP))
unnamed: J1.3, U1.13 (PD7(AIN1))
unnamed: J1.2, U1.12 (PD6(AIN0))
unnamed: J1.1, U1.11 (PD5(T1))
unnamed: Q1.1 (B), R2.2
unnamed: IC1.10 (+IN), J3.3, J3.4, R4.1, RTD.P$1 (1)
unnamed: Q2.1 (B), R3.2
unnamed: IC1.3 (+IN), R5.1, R6.2
unnamed: IC1.1 (OUT), R8.2, R12.1
unnamed: J7.1, R15.1, SET_LED.A
unnamed: J11.1, R14.1, TIM_LED.A
unnamed: J11.2, Q2.3 (C), TIM_LED.K (C)
unnamed: J7.2, Q1.3 (C), SET_LED.K (C)
unnamed: R17.2, VR1.2 (WIPER), VR1.3 (CW)
unnamed: D2.C, D3.A, F1.2
unnamed: ALR_LED.K (C), J2.1, J2.3, J2.5, Q3.3 (C)
unnamed 28: IC1.2 (-IN), R8.1, R17.1; also elsewhere on the board
unnamed: IC1.8 (OUT), R9.1, R13.1
unnamed 30: IC1.9 (-IN), R9.2, VR1.1 (CCW); also elsewhere on the board
unnamed: IC1.5 (+IN), R10.2, R13.2
unnamed: IC1.6 (-IN), R11.1, R12.2
unnamed: R20.2, U2.1 (AC1)
unnamed: R24.2, T1.G
unnamed: R22.2, U3.1
unnamed: R24.1, U3.4
unnamed 37: IC3.4 (FB), R26.1, R27.2; also elsewhere on the board
unnamed: Q4.3 (C), U3.2
unnamed: Q4.1 (B), R25.2
unnamed: J12.1, ON_LED.A, R28.1
unnamed: F1.1, XFMR1.5, XFMR1.7
unnamed 42: C7.+, C9.1, C10.1, C11.1, J8.3, L2.P$2 (2), R26.2, S1.2; also elsewhere on the board
unnamed: ALR_LED.A, J2.2, J2.4, J2.6, R18.1
unnamed: Q3.1 (B), R19.2
unnamed: C4.1, L1.2, U1.20 (AVCC)
unnamed: D1.C, IC3.2 (OUT), L2.P$1 (1)
unnamed: C3.+, C8.+, D3.C, D5.C, IC3.1 (IN)
NEUT: J10.2, J10.3, U2.2 (AC2), XFMR1.4
PWR: J10.1, T1.T1 (A1)
RST: J5.1, R1.1, U1.1 (PC6(/RESET))
RX: J5.2, U1.2 (PD0(RXD))
SCL: J4.4, U1.28 (PC5(ADC5/SCL))
SDA: J4.3, U1.27 (PC4(ADC4/SDA))
SET: R2.1, U1.19 (PB5(SCK))
TX: J5.3, U1.3 (PD1(TXD))
T_EN: R3.1, U1.6 (PD4(XCK/T0))
ZERO: R23.1, TP1.1, U1.4 (PD2(INT0)), U2.4 (C); also elsewhere on the board

Notes on the sheet:
RTD+
RTD-
330u
25V
All Inclusive
LM2576
SET JMP
TIM JMP
ALR JMP
GND TP
ON JMP
PWR JMP
ADC TP
ZERO TP
SUP JMP
RTD JMP
MCP6004

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
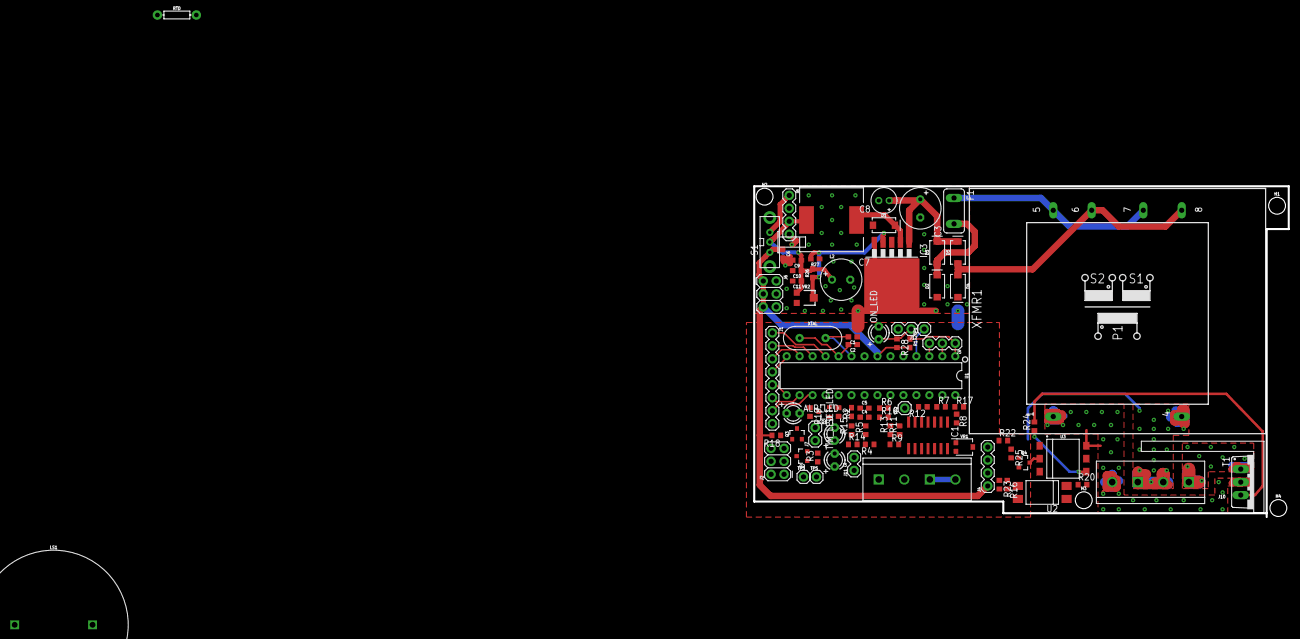
[picture p89: board Granny Safe.brd from above]

Board: 2 copper layers, 104.6 x 64.8 mm, 86 parts (0 on the bottom side), 60 nets.

Other parts of the board:
R7: 10k; R0603
R16: 1M; R0603
VR2: 10k; TRIMPOT-SMD-TC33X

Their connections:
unnamed 28: R7.2; also elsewhere on the board
unnamed 30: R7.1; also elsewhere on the board
unnamed 37: VR2.2; also elsewhere on the board
unnamed 42: VR2.1; also elsewhere on the board
ZERO: R16.2; also elsewhere on the board
