koson/Senior-Project/(commit log)

2023-02-16 add kicad
    [Granny Safe Microprocessor Module.kicad_sch, Granny Safe Power Supply.kicad_sch, Granny Safe all Inclusive.kicad_sch, Granny Safe.kicad_sch, Report Cut-up schematic.kicad_sch, Temp Sensor B.kicad_sch, Temp Sensor C.kicad_sch, Temp Sensor.kicad_sch]
2023-02-16 Create Temp Sensor_21-2023-02-16_135025.zip
